cupcake08/raah/case/fusion/assets/screen_map_4x.png

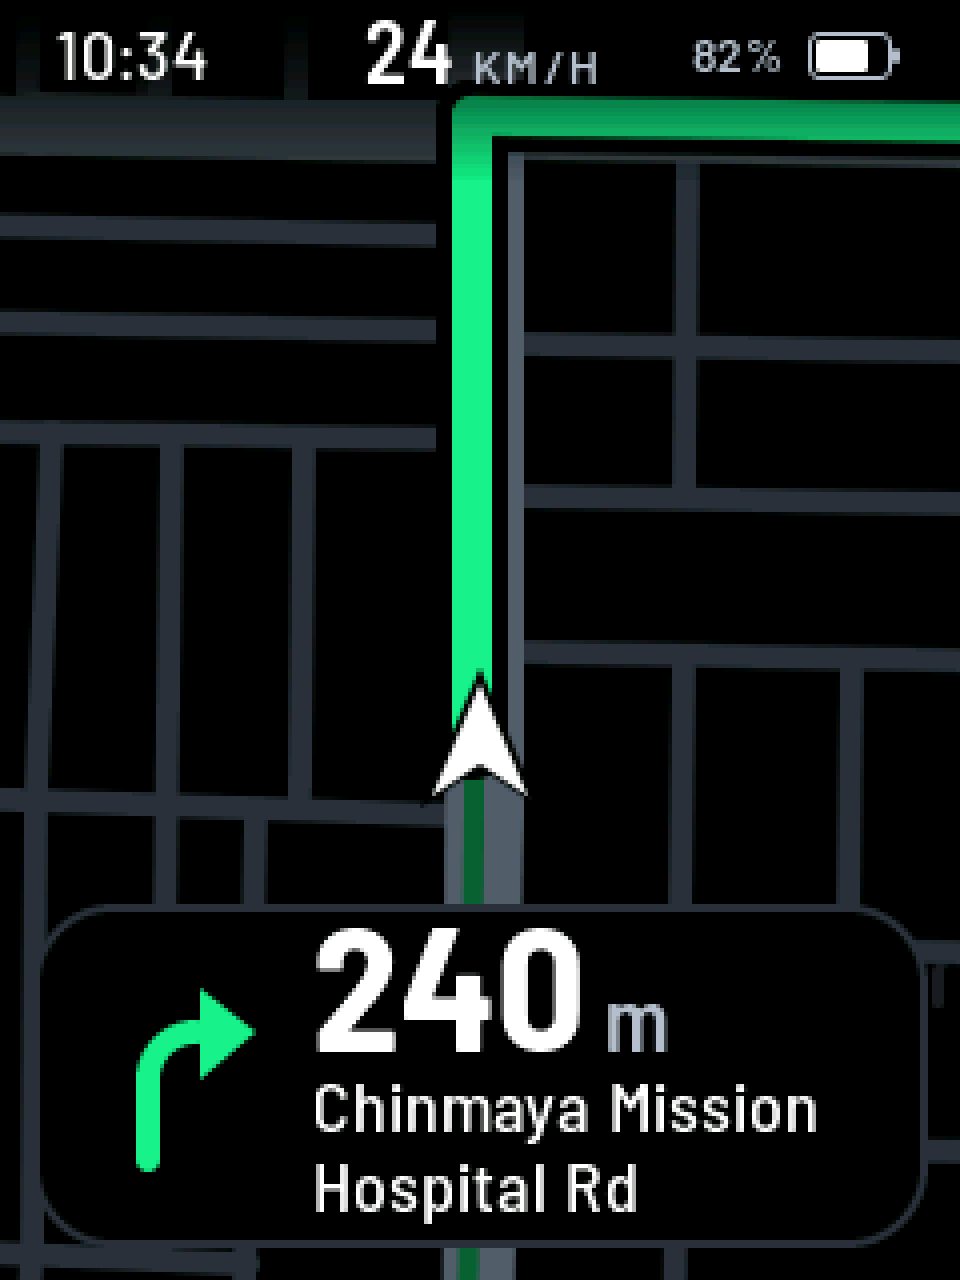
case/fusion/assets/screen_map_4x.png
