cupcake08/raah/case/fusion/assets/screen_map_4x_flipped.png

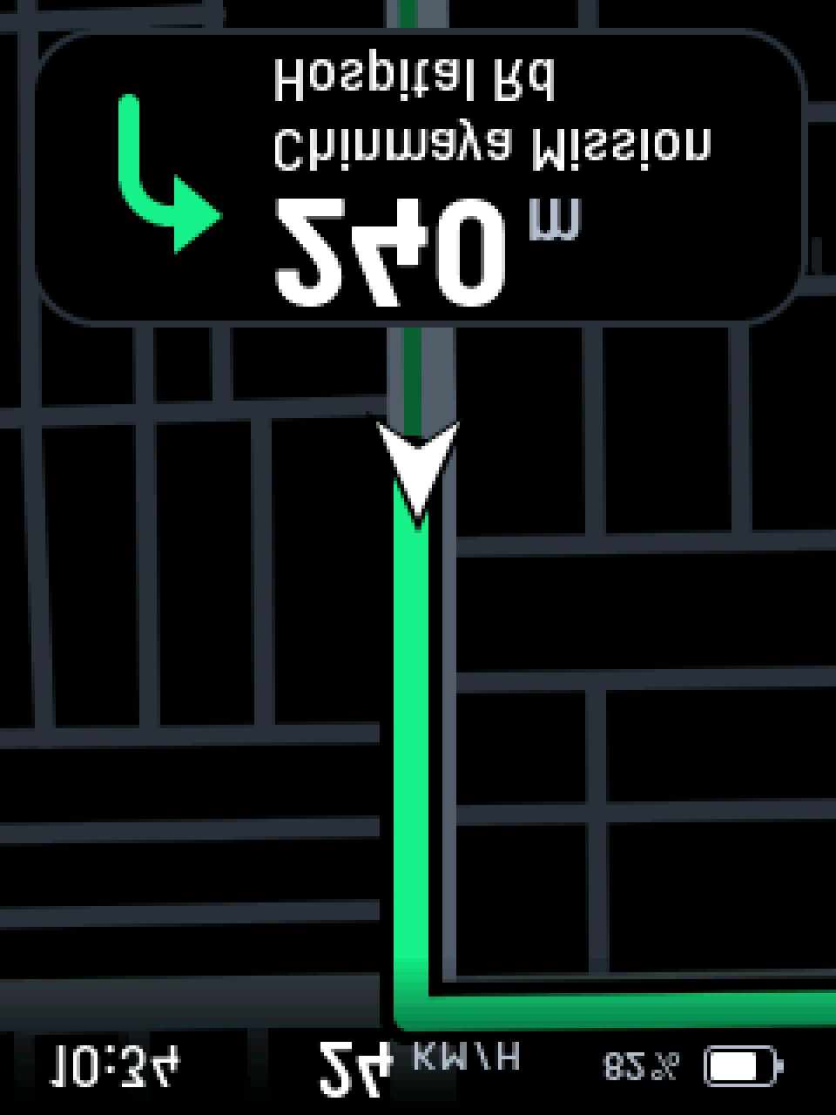
case/fusion/assets/screen_map_4x_flipped.png
