cupcake08/raah/case/renders/01_hero_mounted.png

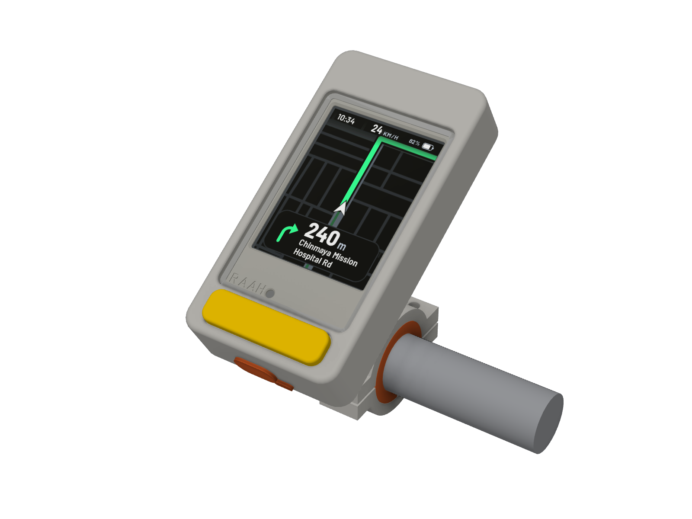
case/renders/01_hero_mounted.png
