cupcake08/raah/case/renders/02_face.png

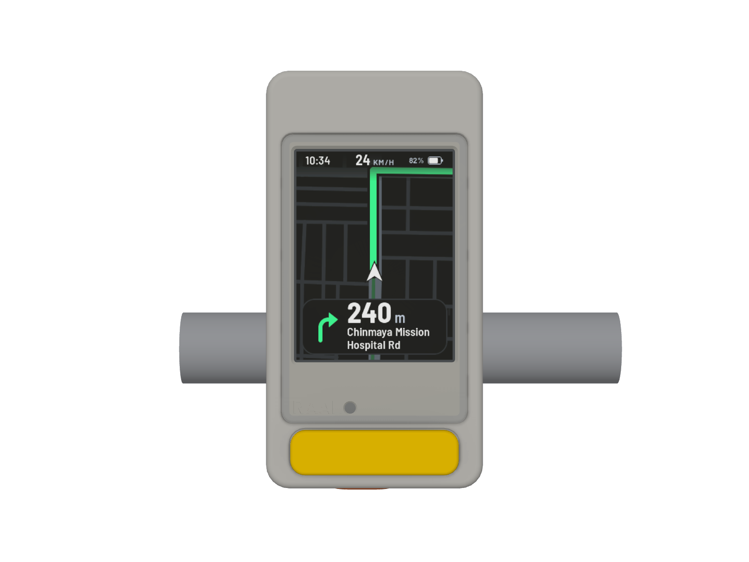
case/renders/02_face.png
