cupcake08/raah/case/renders/03_side_tilt.png

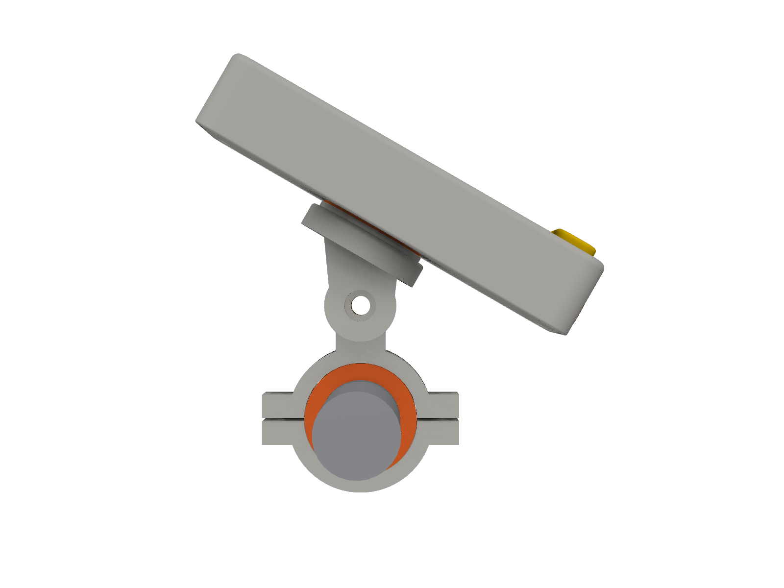
case/renders/03_side_tilt.png
