cupcake08/raah/case/renders/04_back_mount.png

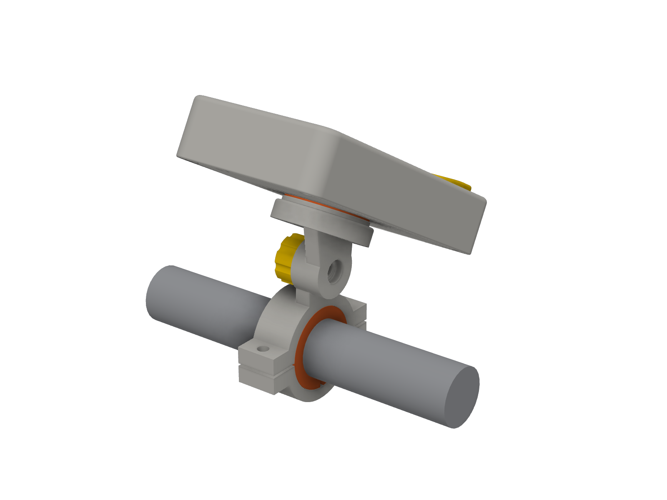
case/renders/04_back_mount.png
