cupcake08/raah/case/renders/05_back_tab.png

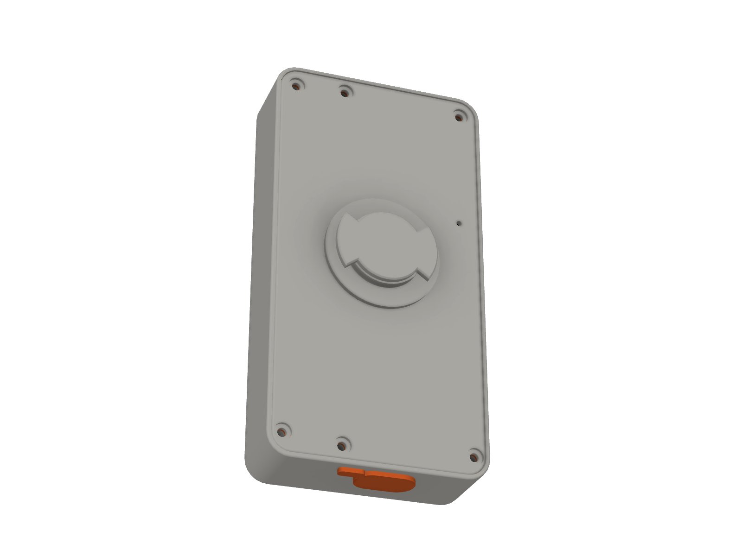
case/renders/05_back_tab.png
