cupcake08/raah/case/renders/06_inside_lid.png

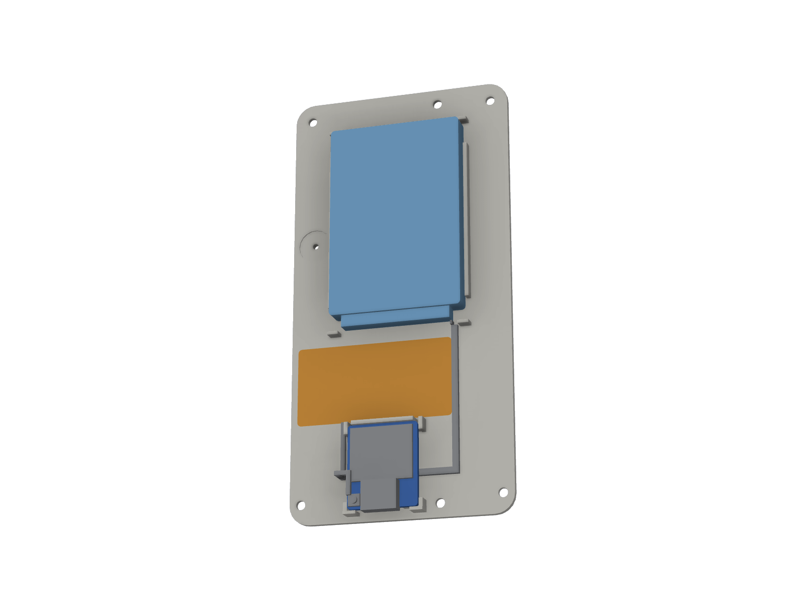
case/renders/06_inside_lid.png
