cupcake08/raah/case/renders/07_inside_shell.png

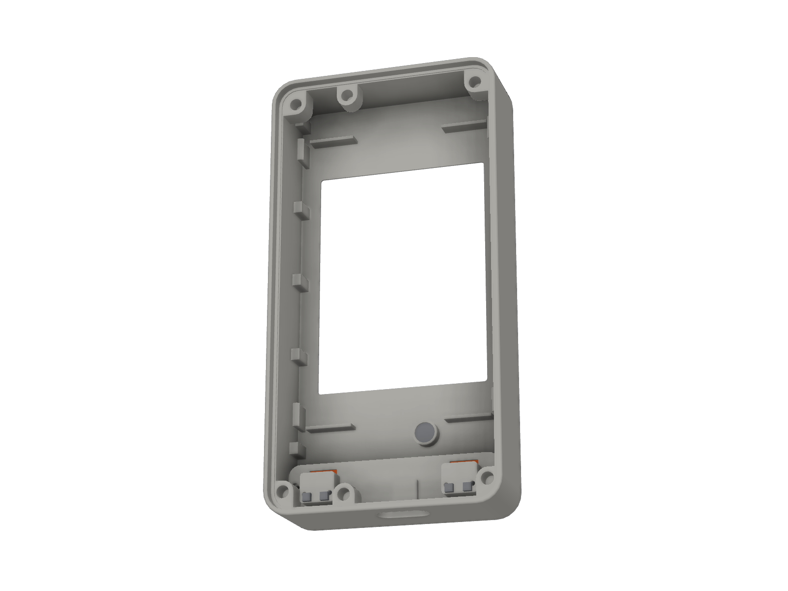
case/renders/07_inside_shell.png
