cupcake08/raah/case/renders/08_exploded.png

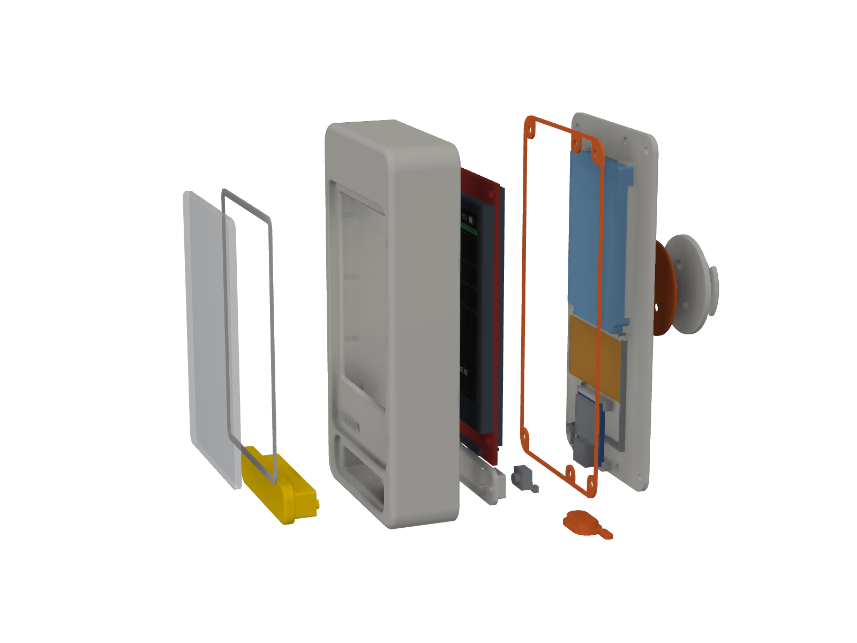
case/renders/08_exploded.png
