cupcake08/raah/case/renders/hq/back.jpg

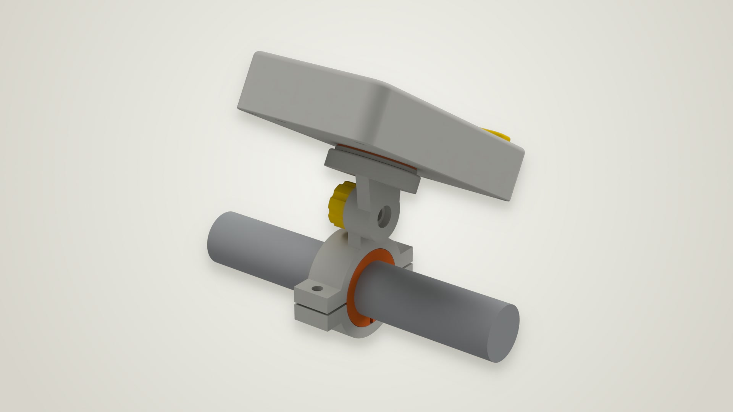
case/renders/hq/back.jpg
