cupcake08/raah/case/renders/hq/back_cutout.png

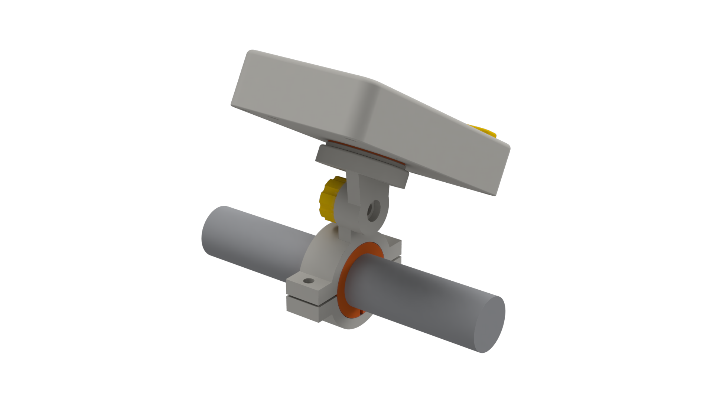
case/renders/hq/back_cutout.png
