cupcake08/raah/case/renders/hq/exploded.jpg

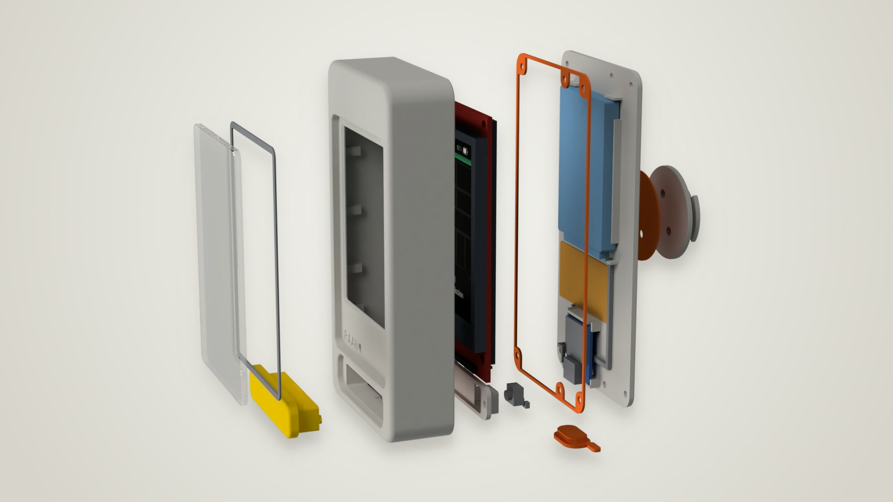
case/renders/hq/exploded.jpg
