cupcake08/raah/case/renders/hq/exploded_cutout.png

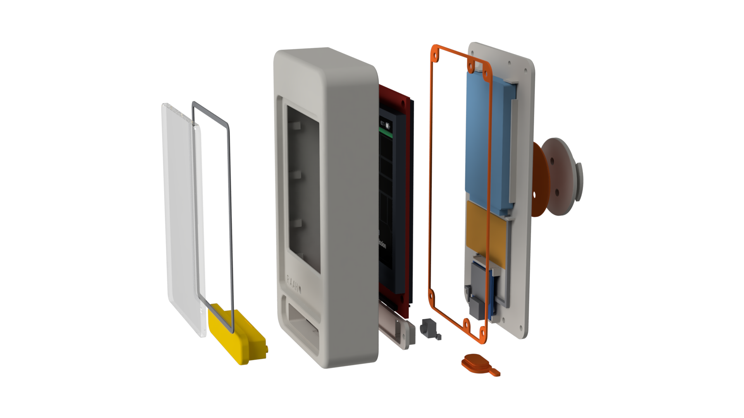
case/renders/hq/exploded_cutout.png
