cupcake08/raah/case/renders/hq/face.jpg

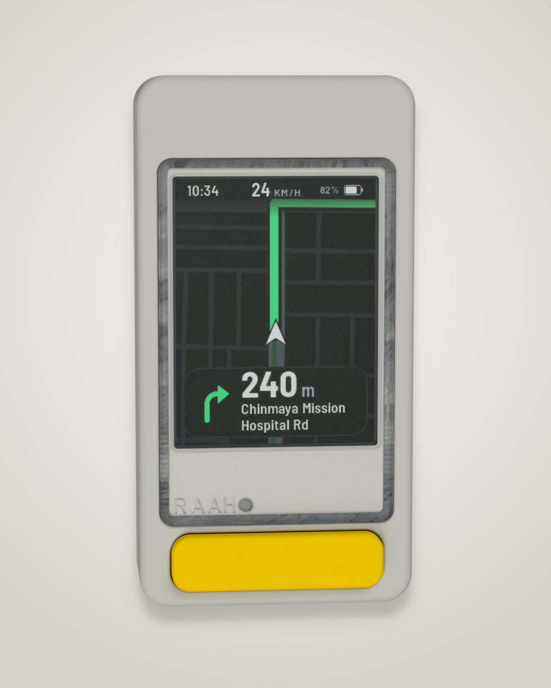
case/renders/hq/face.jpg
