cupcake08/raah/case/renders/hq/face_cutout.png

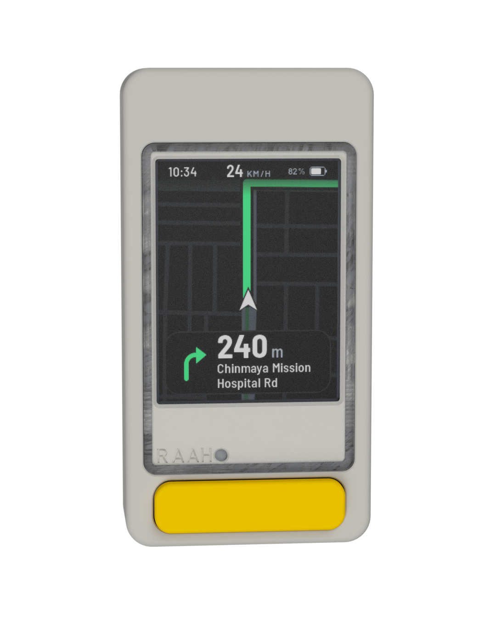
case/renders/hq/face_cutout.png
