cupcake08/raah/case/renders/hq/hero_cutout.png

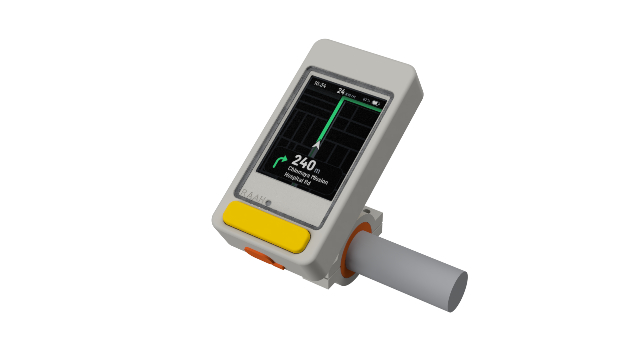
case/renders/hq/hero_cutout.png
