cupcake08/raah/case/renders/hq/inside.jpg

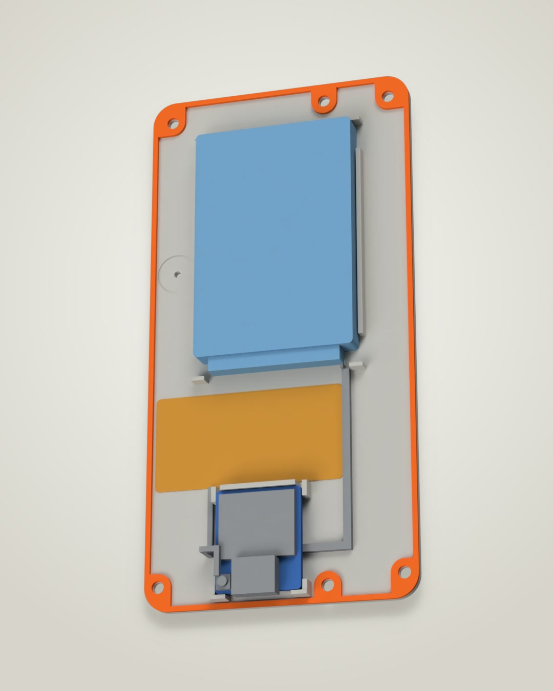
case/renders/hq/inside.jpg
