cupcake08/raah/case/renders/hq/inside_cutout.png

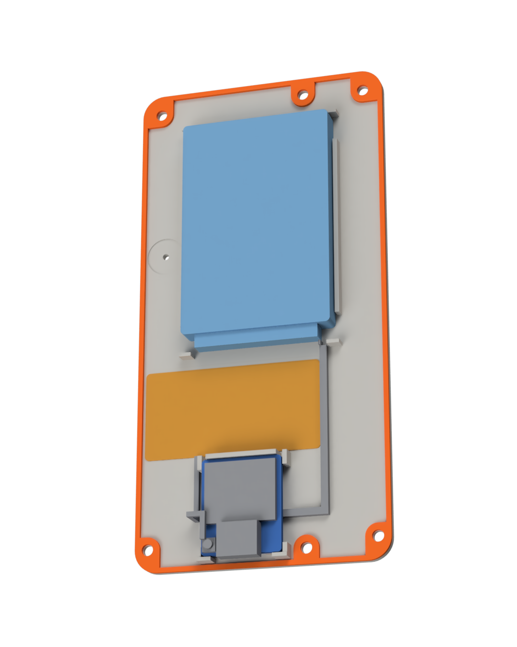
case/renders/hq/inside_cutout.png
