cupcake08/raah/case/renders/hq/side.jpg

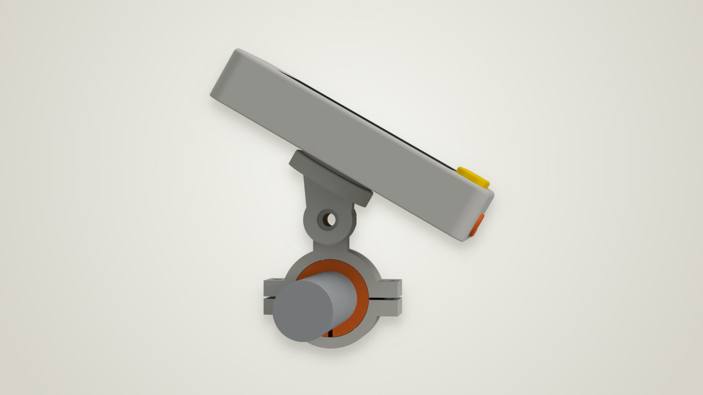
case/renders/hq/side.jpg
