cupcake08/raah/case/renders/hq/side_cutout.png

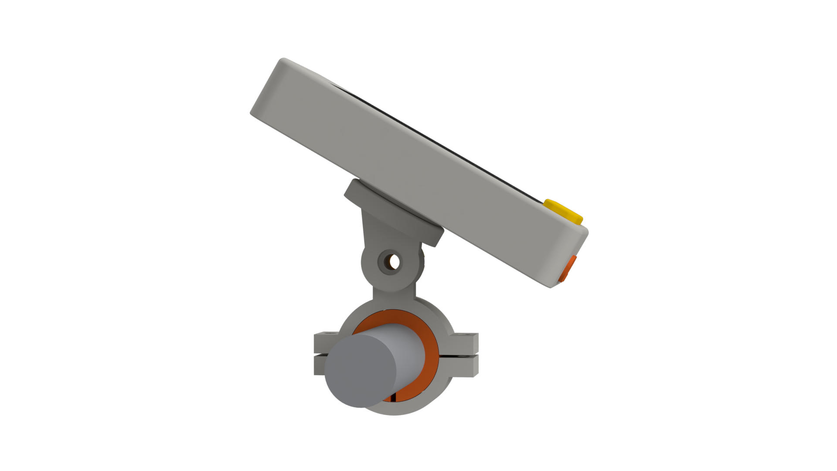
case/renders/hq/side_cutout.png
