cupcake08/raah/case/renders/hq/three_quarter.jpg

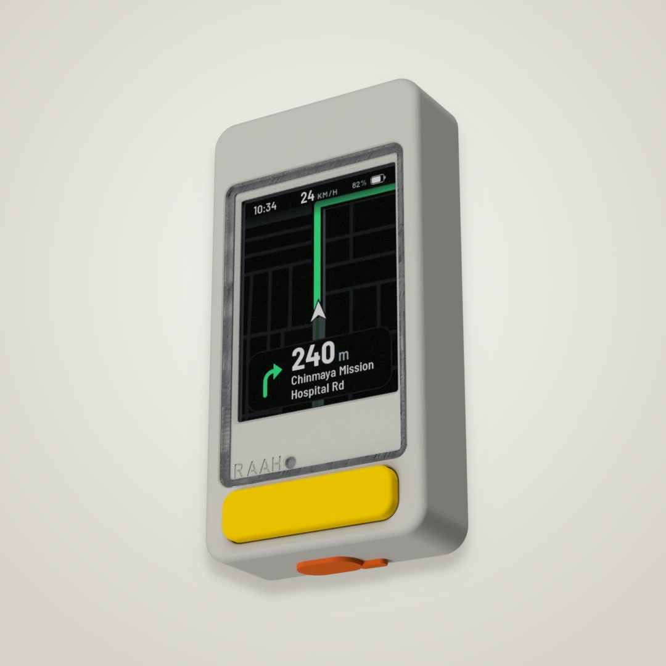
case/renders/hq/three_quarter.jpg
