cupcake08/raah/case/renders/hq/three_quarter_cutout.png

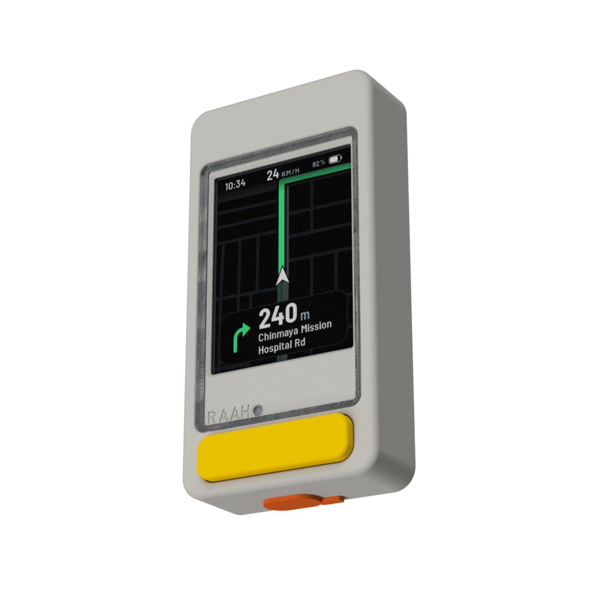
case/renders/hq/three_quarter_cutout.png
