cupcake08/raah/case/renders/raah_turntable.gif

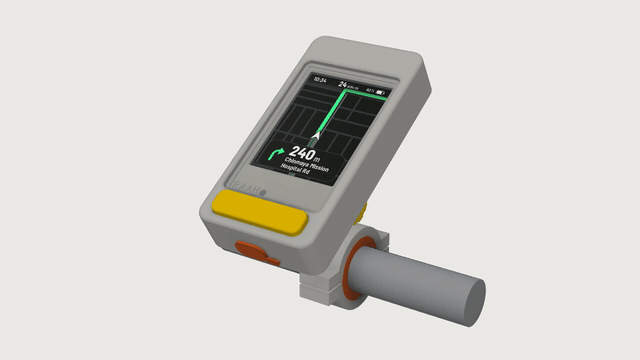
case/renders/raah_turntable.gif
