cupcake08/raah/docs/screens/01_waiting.png

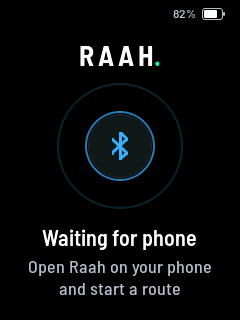
docs/screens/01_waiting.png
