cupcake08/raah/docs/screens/02_idle.png

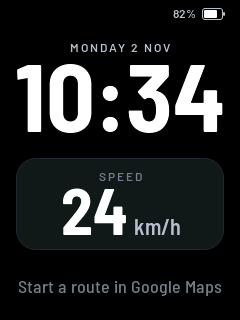
docs/screens/02_idle.png
