cupcake08/raah/docs/screens/03_cruise.png

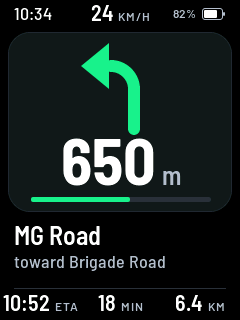
docs/screens/03_cruise.png
