cupcake08/raah/docs/screens/04_near.png

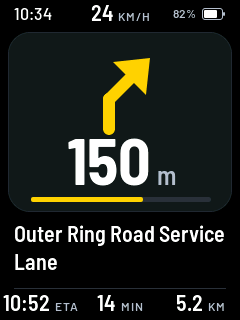
docs/screens/04_near.png
