cupcake08/raah/docs/screens/05_turn_now.png

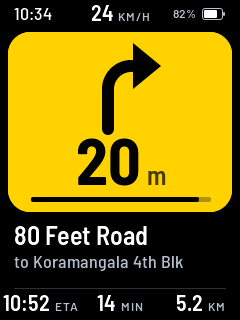
docs/screens/05_turn_now.png
