cupcake08/raah/docs/screens/06_roundabout.png

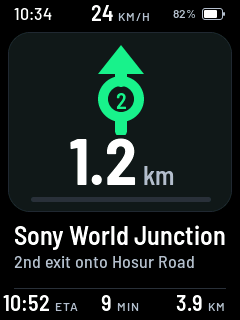
docs/screens/06_roundabout.png
