cupcake08/raah/docs/screens/08_rerouting.png

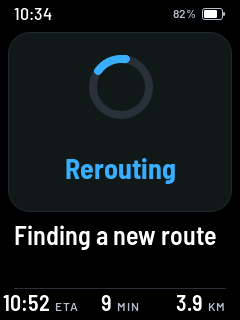
docs/screens/08_rerouting.png
