cupcake08/raah/docs/screens/09_arrived.png

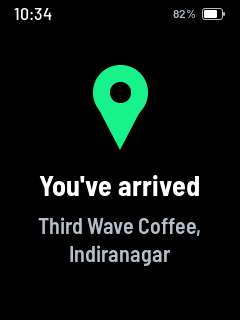
docs/screens/09_arrived.png
