cupcake08/raah/docs/screens/12_map_near.png

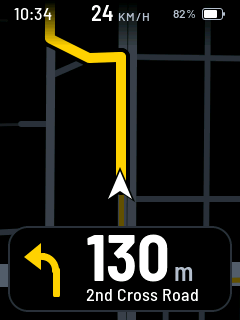
docs/screens/12_map_near.png
