cupcake08/raah/docs/screens/13_map_fast.png

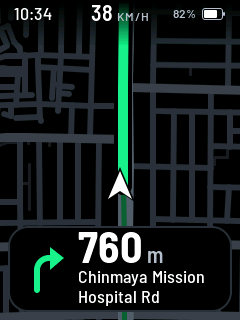
docs/screens/13_map_fast.png
