cupcake08/raah/docs/screens/14_map_now.png

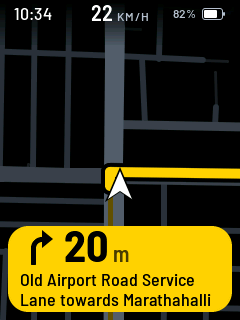
docs/screens/14_map_now.png
