cupcake08/raah/docs/screens/15_map_stopped.png

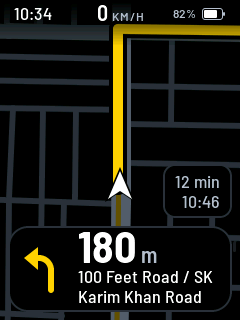
docs/screens/15_map_stopped.png
