cupcake08/raah/docs/screens/round_contact_sheet.png

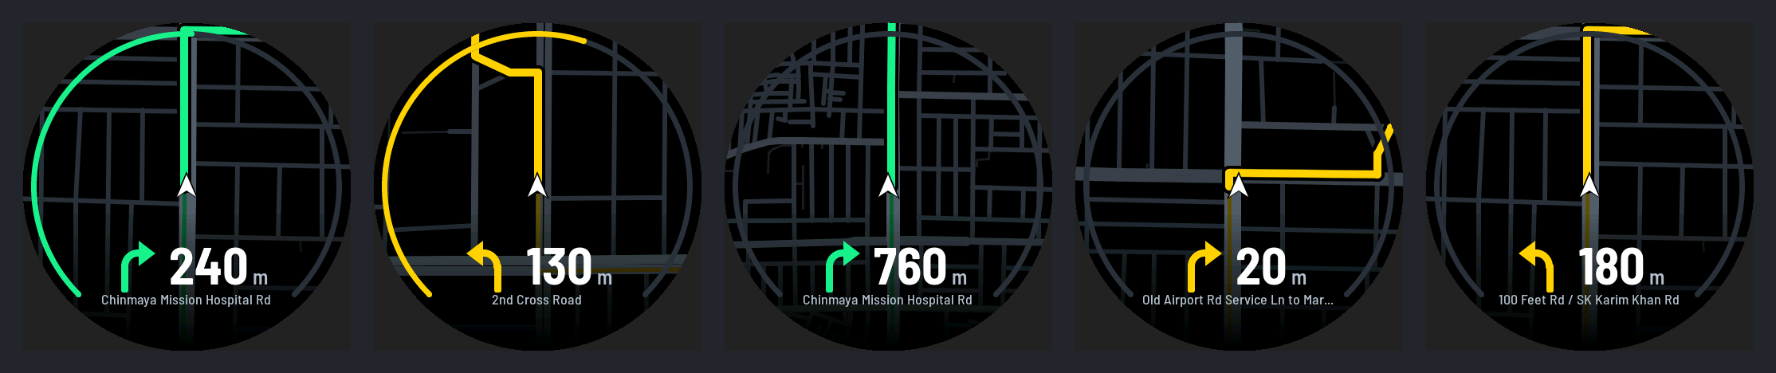
docs/screens/round_contact_sheet.png
