cupcake08/raah/docs/screens/round_r1_map_cruise.png

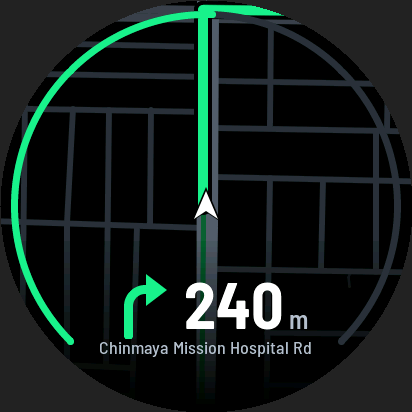
docs/screens/round_r1_map_cruise.png
