cupcake08/raah/docs/screens/round_r2_map_near.png

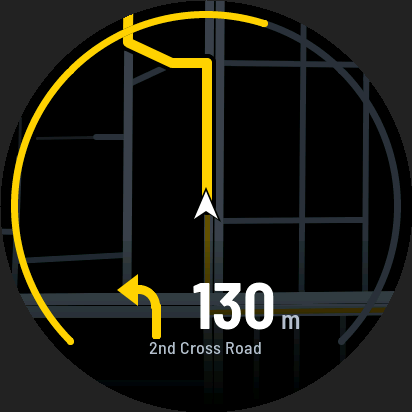
docs/screens/round_r2_map_near.png
