cupcake08/raah/docs/screens/round_r3_map_fast.png

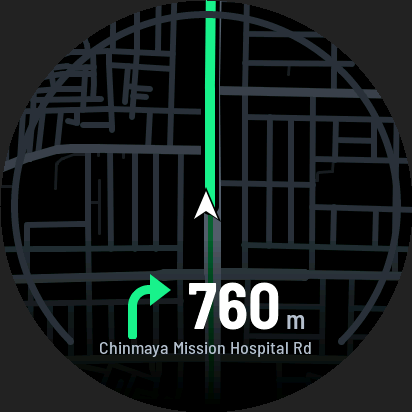
docs/screens/round_r3_map_fast.png
