cupcake08/raah/docs/screens/round_r4_map_now.png

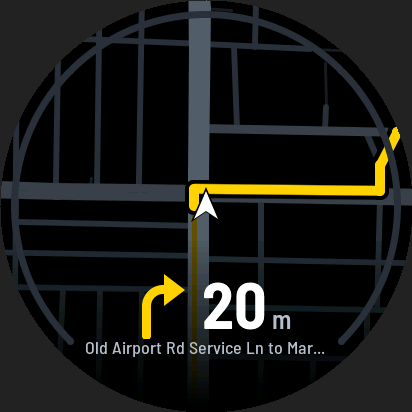
docs/screens/round_r4_map_now.png
