cupcake08/raah/docs/screens/round_r5_map_stopped.png

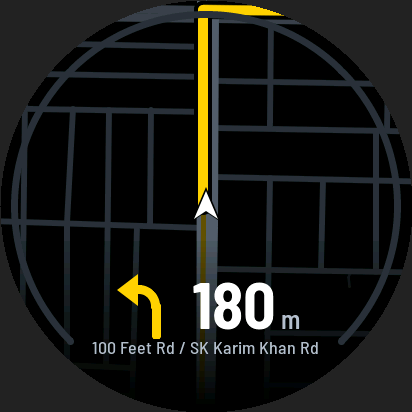
docs/screens/round_r5_map_stopped.png
