cupcake08/raah/case/exports/raah_assembly.step

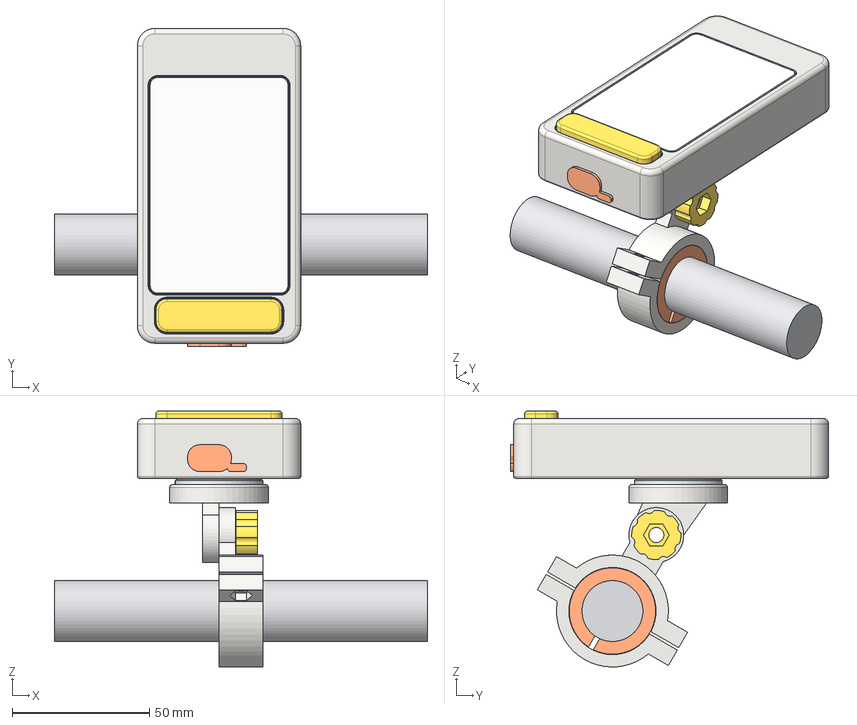
[picture p52: CAD file, 2026-11-03]
case/exports/raah_assembly.step
136.0 x 116.0 x 93.3 mm
