cupcake08/raah/case/exports/raah_lid_gasket.stl

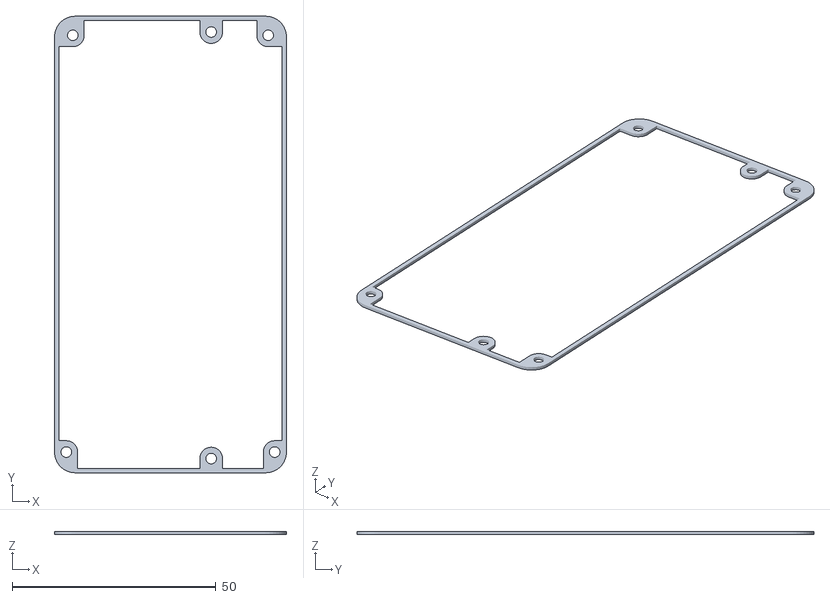
[picture p53: CAD file, 2026-11-03]
case/exports/raah_lid_gasket.stl
57.0 x 112.2 x 0.8
