cupcake08/raah/case/exports/raah_front_shell.stl

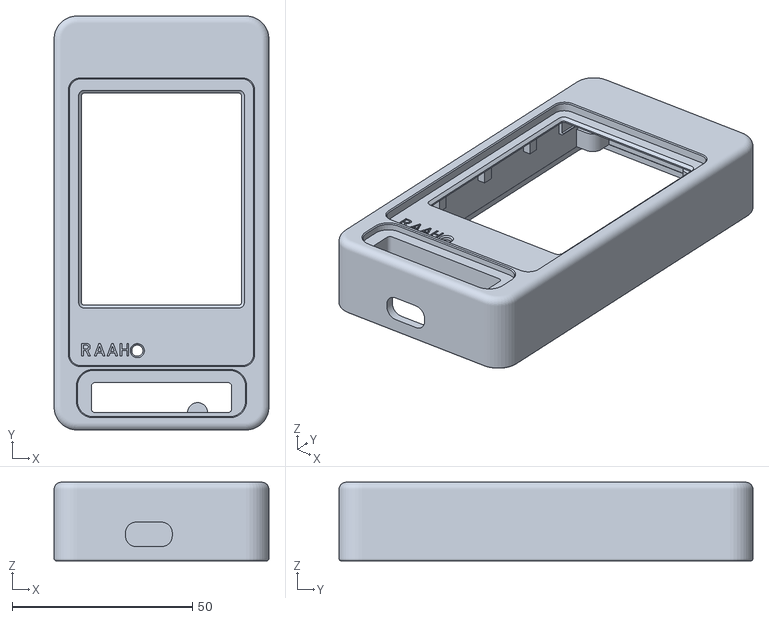
[picture p54: CAD file, 2026-11-03]
case/exports/raah_front_shell.stl
59.6 x 114.8 x 21.8
