cupcake08/raah/case/exports/raah_clamp_lower.stl

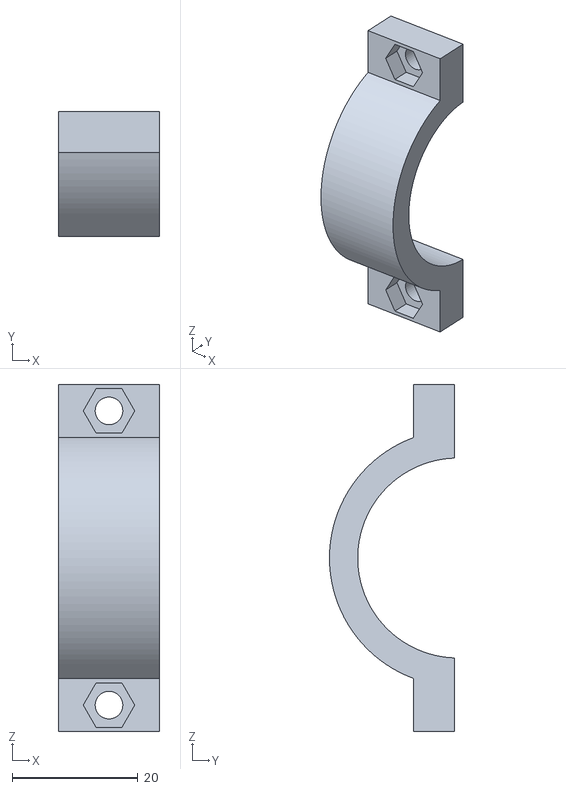
[picture p55: CAD file, 2026-11-03]
case/exports/raah_clamp_lower.stl
16.0 x 19.9 x 55.2
