cupcake08/raah/case/exports/raah_tab_gasket.stl

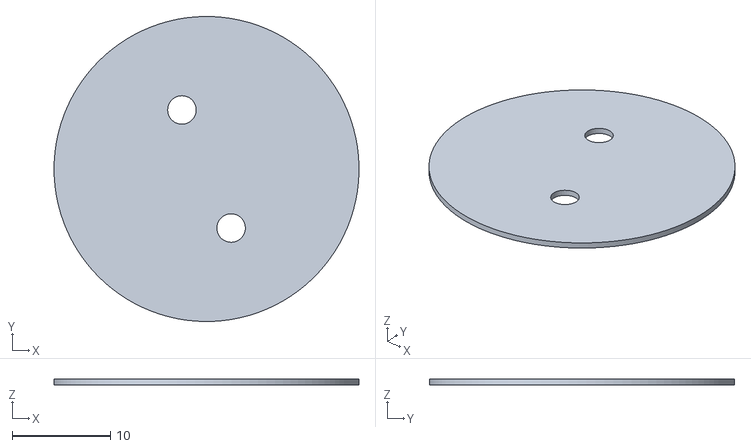
[picture p56: CAD file, 2026-11-03]
case/exports/raah_tab_gasket.stl
31.0 x 31.0 x 0.6
