cupcake08/raah/case/exports/raah_key_membrane.stl

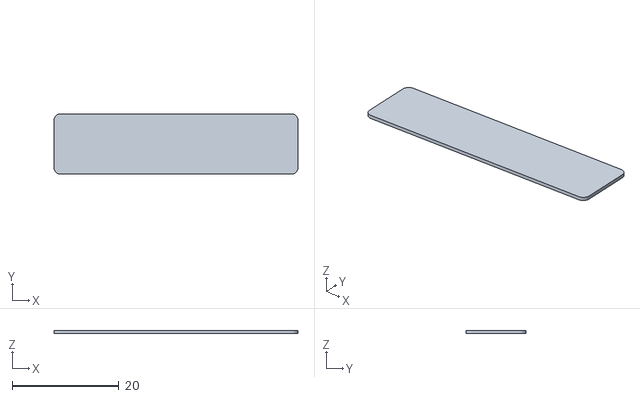
[picture p57: CAD file, 2026-11-03]
case/exports/raah_key_membrane.stl
45.7 x 11.3 x 0.6
