cupcake08/raah/case/exports/raah_clamp_upper.stl

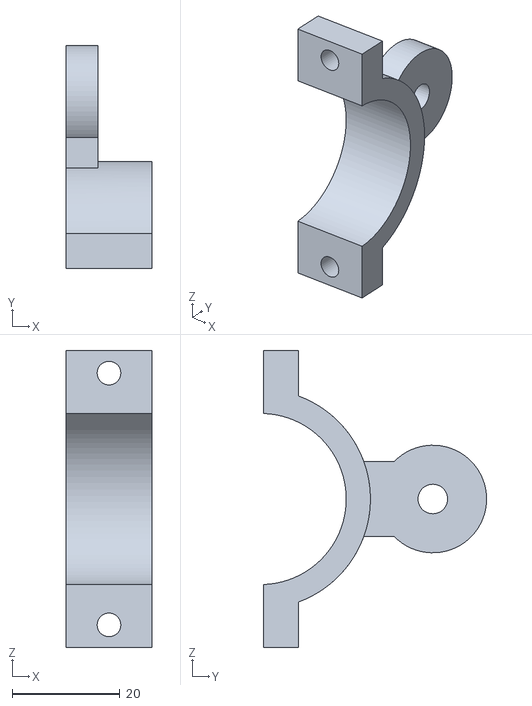
[picture p58: CAD file, 2026-11-03]
case/exports/raah_clamp_upper.stl
16.0 x 41.5 x 55.2
