cupcake08/raah/case/exports/raah_display_gasket.stl

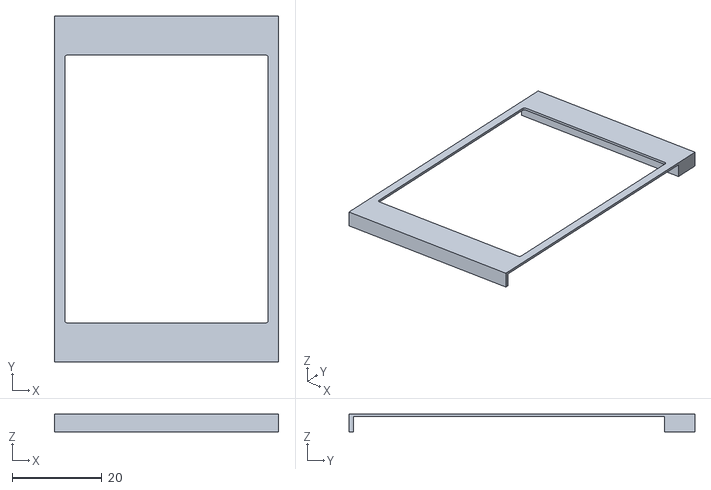
[picture p59: CAD file, 2026-11-03]
case/exports/raah_display_gasket.stl
50.0 x 77.2 x 4.00
