cupcake08/raah/case/exports/raah_key.stl

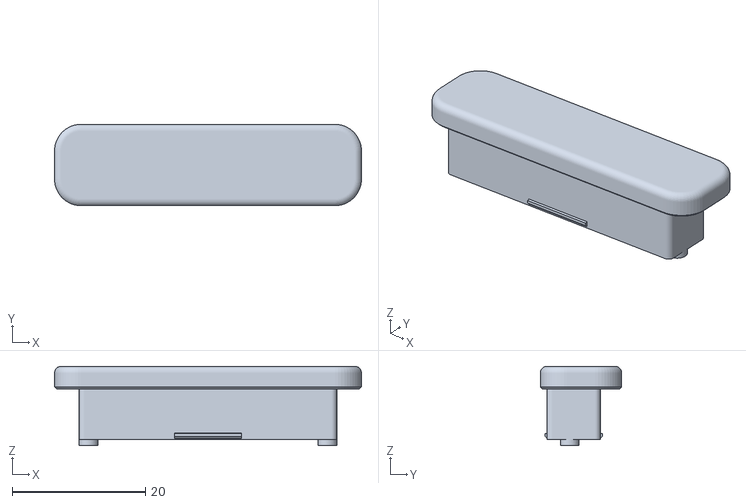
[picture p60: CAD file, 2026-11-03]
case/exports/raah_key.stl
46.0 x 12.2 x 11.9
