cupcake08/raah/case/exports/raah_bar_shim_222.stl

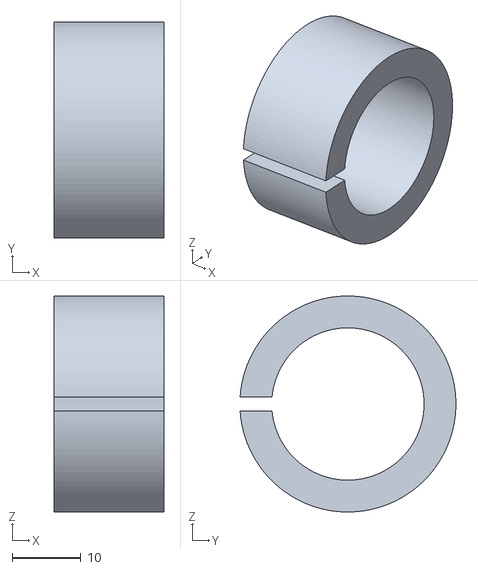
[picture p61: CAD file, 2026-11-03]
case/exports/raah_bar_shim_222.stl
16.0 x 31.5 x 31.5
