cupcake08/raah/case/exports/raah_lens_tape_vhb.dxf

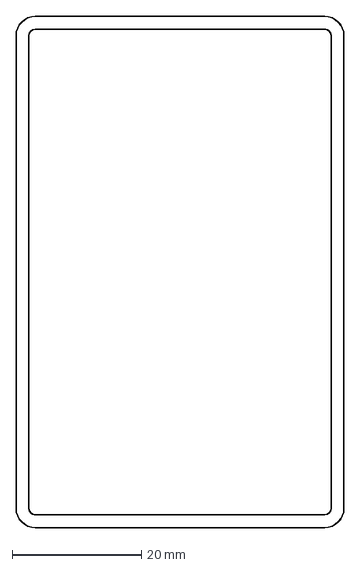
[picture p62: CAD file, 2026-11-03]
case/exports/raah_lens_tape_vhb.dxf
50.8 x 79.2 mm
