cupcake08/raah/case/exports/raah_switch_carrier.stl

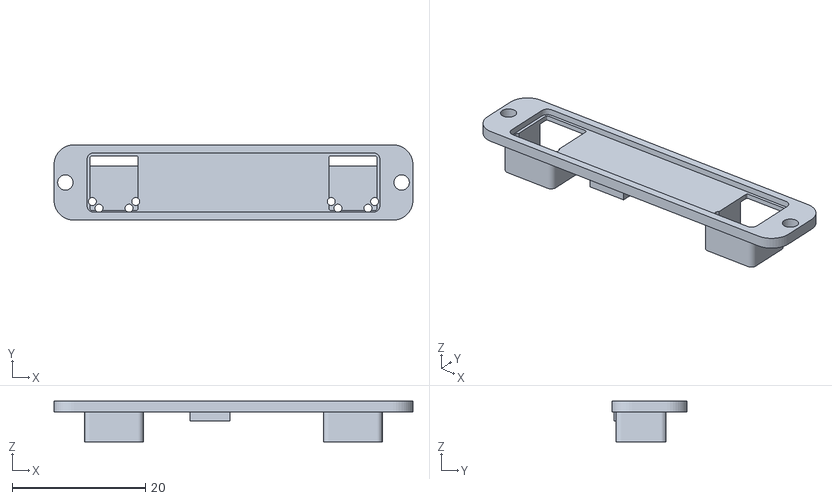
[picture p63: CAD file, 2026-11-03]
case/exports/raah_switch_carrier.stl
53.8 x 11.3 x 6.10
