cupcake08/raah/case/exports/raah_receiver_arm.stl

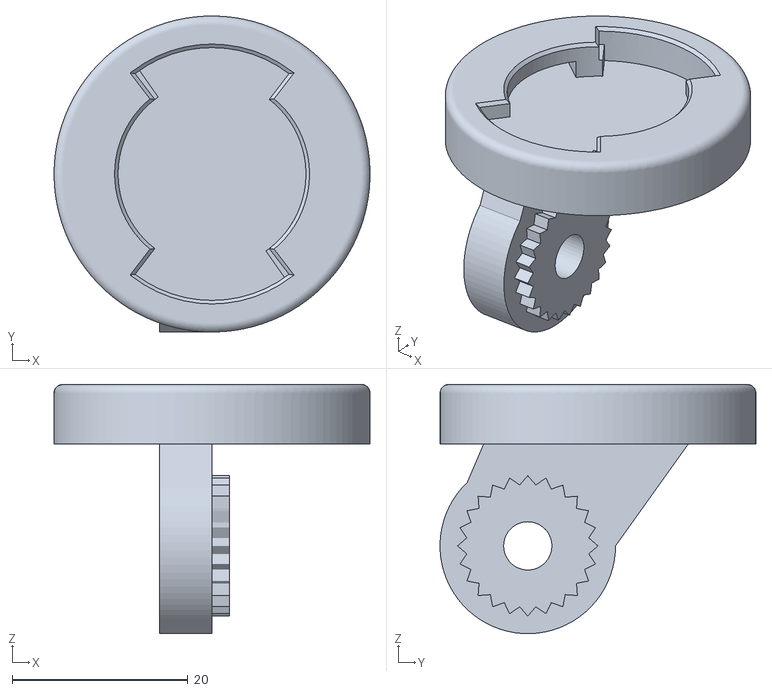
[picture p64: CAD file, 2026-11-03]
case/exports/raah_receiver_arm.stl
36.0 x 36.0 x 28.4
