cupcake08/raah/case/exports/raah_tilt_knob.stl

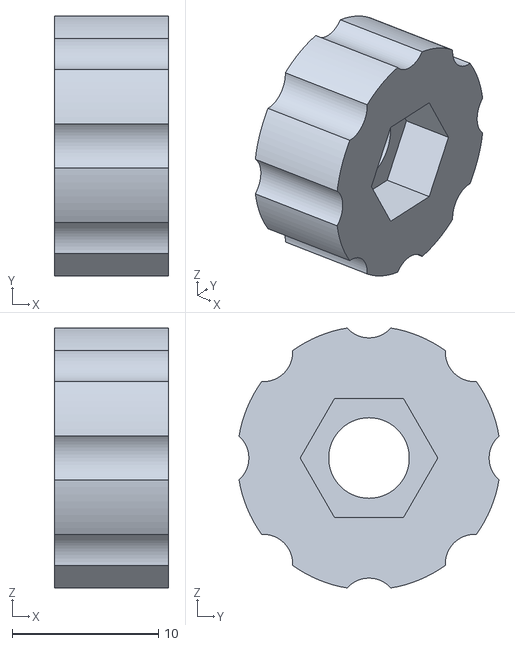
[picture p65: CAD file, 2026-11-03]
case/exports/raah_tilt_knob.stl
7.80 x 17.7 x 17.7
