cupcake08/raah/case/exports/raah_usb_plug.stl

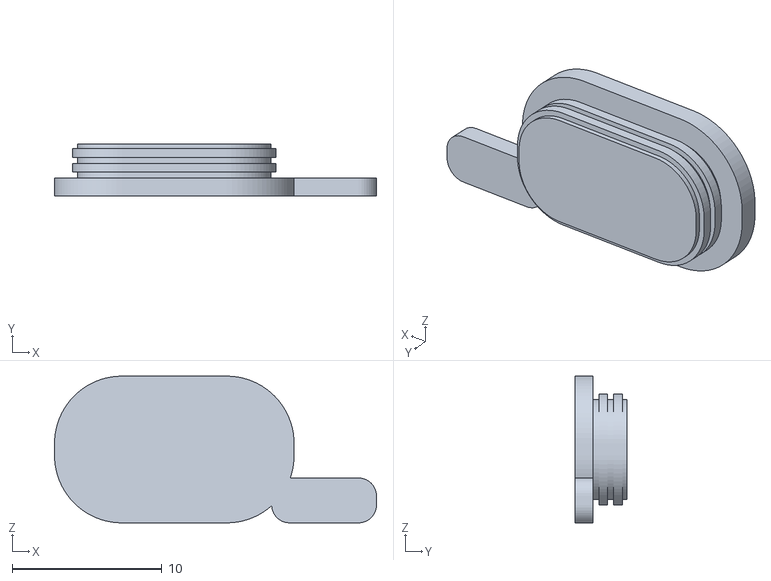
[picture p66: CAD file, 2026-11-03]
case/exports/raah_usb_plug.stl
21.5 x 3.50 x 9.80
