cupcake08/raah/case/exports/raah_lens.dxf

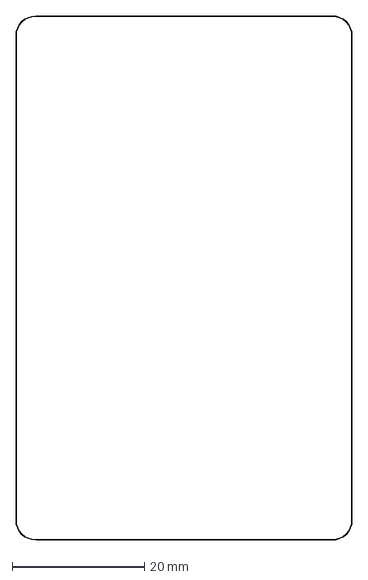
[picture p67: CAD file, 2026-11-03]
case/exports/raah_lens.dxf
50.8 x 79.2 mm
