cupcake08/raah/case/exports/raah_quarter-turn_tab.stl

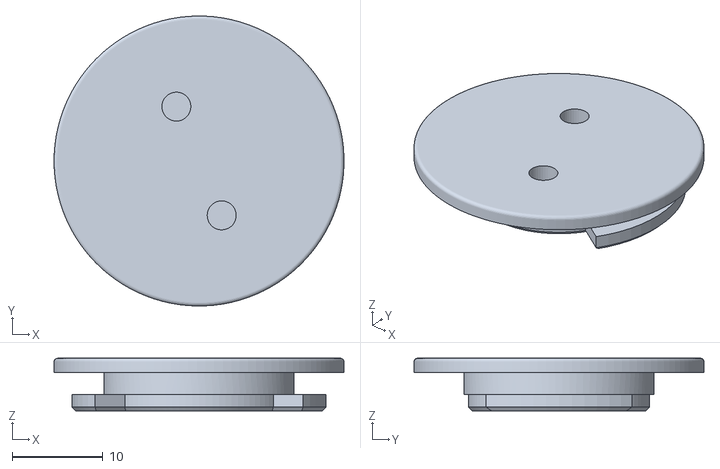
[picture p68: CAD file, 2026-11-03]
case/exports/raah_quarter-turn_tab.stl
32.0 x 32.0 x 5.80
