cupcake08/raah/case/exports/raah_lid.stl

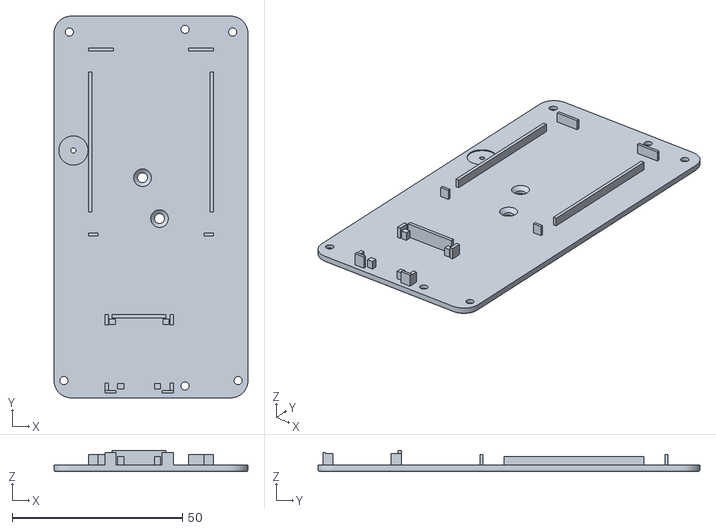
[picture p69: CAD file, 2026-11-03]
case/exports/raah_lid.stl
57.0 x 112.2 x 6.30
