cupcake08/raah/(commit log)

2026-11-03 Raah: ESP32-S3 handlebar navigator and its Android app
    Firmware (ESP-IDF 6, LVGL 9) for an ESP32-S3 with a 240x320 ILI9341 panel:
    a heading-up vector map with a floating turn card, a turn-card mode, BLE
    link to the phone, and power management. Host simulator and render
    benchmark included.
    Android companion app (Compose): search as you type (Photon/OSM), share
    from Google Maps, route preview over nearby streets, Home/Work/recent
    places, a ride screen that mirrors the device, Valhalla routing,
    OpenFreeMap roads streamed to the device, and Google Maps mirroring.
2026-11-03 Android: Google search, Google Maps sharing, pocket rides, icon and splash
    Search asks the phone's geocoder (Google) and Photon together, near the
    rider, and names places by what was asked rather than the road they're on.
    Google Maps share links without coordinates are looked up by name and
    address. Launcher shortcuts ride home, to work, or open search, and a
    recent place can be forgotten with a long press.
    Rides keep going in a pocket: the foreground service holds a wake lock
    while riding, its notification shows the next turn on the lock screen,
    Home asks once to lift battery limits, and a restart from the background
    falls back to the connected-device type instead of crashing.
    Fixes a rid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
2026-11-03 Firmware power pass: draw less, and nothing while dark
    - A dark screen draws nothing; lighting it redraws once first.
    - Dimmed, the map glides in 6 px steps at most 4 times a second.
    - The status bar sits on a solid band, so map frames skip its text.
    - Circle cache 4 -> 16 slots, and 40-row render strips.
    A riding frame on the chip goes from 96 ms to 61 ms, and the CPU draws
    about 5-8% of the time while cruising dimmed, against about 19%. The
    bench times each overlay object (ui_bench_parts), and the log notes the
    backlight and screen on/off. README documents the numbers and the app's
    pocket behaviour.
    [display.c, display.h, main.c, ui.c, ui.h, ui_map.c]
2026-11-03 Firmware: port to the Seeed XIAO ESP32C3, the case's board
    The firmware now builds for the XIAO ESP32C3 by default and still builds for
    the ESP32-S3 test board with `idf.py set-target esp32s3`.
    - Per-board settings in sdkconfig.defaults.<target>. The C3 gets 4 MB flash,
    its console on the native USB (the display takes the UART pins), and a
    48 KB LVGL pool.
    - Pins default per target in Kconfig, following the case's wiring:
    - display SCK 6, MOSI 7, CS 10, DC 8, RST 20, backlight 21
    - key 5
    - battery ADC 4
    - LDR ADC 3
    - Deep sleep wakes on the key through GPIO wakeup on the C3, which has no
    RTC IO; ext1 stays on the S3.
    - The UI task runs on the last core: core 1 on the S3, the o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
2026-11-03 Case: sealed handlebar enclosure for the XIAO ESP32C3
    A 3D-printable case with a quarter-turn bar mount, built around the XIAO
    ESP32C3, a 523450 cell and the 2.8" ILI9341. It is 21.8 mm deep.
    - fusion/raah_case.py builds the model in Fusion 360. The interference check
    finds 0 clashes with the display either way up.
    - exports/ has the STL for every printed part, the assembly as STEP, and the
    lens and lens tape as DXF.
    - renders/ has the stills, the assembly and turntable animations, and
    ray-traced product shots with a 720p showcase film. fusion/ has the scripts
    that make them.
    - DESIGN.md covers the assembly steps, the XIAO wiring, parts to buy in India
    and what hasn't been verifie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
    [raah_assembly.step, raah_bar_shim_222.stl, raah_clamp_lower.stl, raah_clamp_upper.stl, raah_display_gasket.stl, raah_front_shell.stl, raah_key.stl, raah_key_membrane.stl]
2026-11-03 README: show the case turntable and assembly GIFs
    The top of the README now shows the ray-traced turntable and the assembly
    animation side by side, and links the 720p assembly video, product film and
    turntable (GitHub doesn't play repo MP4s inline).
    case/DESIGN.md: add element14 India, the cheapest C3 source, and Robobazar,
    and fix the Robu link.
2026-11-04 UI: the map runs under the status bar again, behind a fade
    The solid band under the status bar saved 9.6 ms a frame when strips were
    20 rows tall and its text was drawn twice. With 40-row strips the fade costs
    2 ms: on the chip, a riding frame takes 63 ms with it and 61 ms with the
    band. That is a small part of the drawing time, and drawing is a small part
    of the battery next to the backlight. So the map shows under the clock,
    speed and battery again.
    The map no longer needs to know about an opaque band (ui_map_set_top_cover
    is gone), and the benchmark finds the fade and card at their new places.
    [ui.c, ui_map.c, ui_map.h]
